MarcelKleiner/BallBalncer/00_General/AngleCalculation.docx

# Angle Calculation

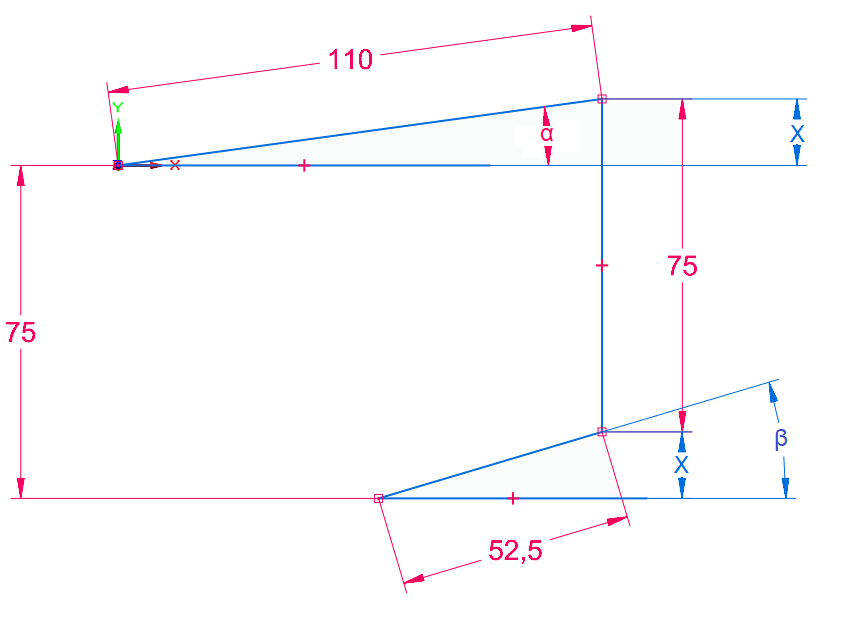
[picture p1: figure]

Target angle: α

x=sin(β)∙52.5=sin(α)∙110

β= sin^(-1) (110/52.5 ∙sin⁡(α) )

i∙EncoderValue= sin^(-1) (110/52.5∙sin⁡(α) ) where i = transmission ratio
