MarcelKleiner/BallBalncer/00_General/GateResistorCalculation.docx

# Gate resistor calculation

Calculation based on: https://www.ti.com/lit/ab/slla385a/slla385a.pdf?ts=1703426401381

(retrieved on 24.12.2023)

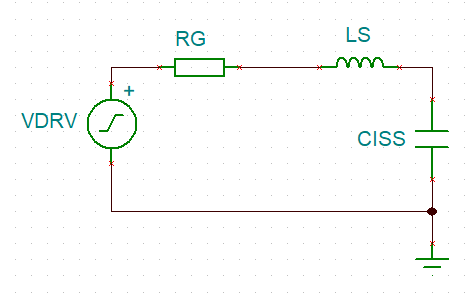
[picture p2: figure]

Calculating the source inductance Ls

L_S =1/(C_(ISS) *(2πf_R )^2)

The CISS of the DMN10H220LK3 is 384pF and a ring frequency of 4MHz

L_S =1/(384*(2π∙4000000)^2)= 4.122x10^(-6)

We need a quality factor Q between 0.5 and 1. A Value greater than 0.5 has a better dV/dt.
Q is defined as follow:

Q=(X_L)/(R_G)= (ωL_s)/(R_G)=>R_G =2πfL_s Q

With a Q of 0.7 we get a R_G of:

(2π∙4000000∙4.122x10^(-6))/0.5=207Ohm

To obtain the gate resistor, we need to subtract the gate resistor of the MOSFET (RG,I) and the resistor RHI or RLO of the gate driver. (RG = RHI or LO+RGATE+RG,I)

RGATE = 2.4Ohm (DMN10H220LK3)

Unfortunately, there is no reference to the RHI or RLO of the gate driver in the data sheet. We therefore assume that this is 0 ohms.

This results in a gate resistance of around 205 ohms.

Note: I have assumed that the ring frequency is 4 MHz. This value must be measured in order to obtain a correct result.
