MarcelKleiner/BallBalncer/01_Mechanical/gikr6-pw.stp

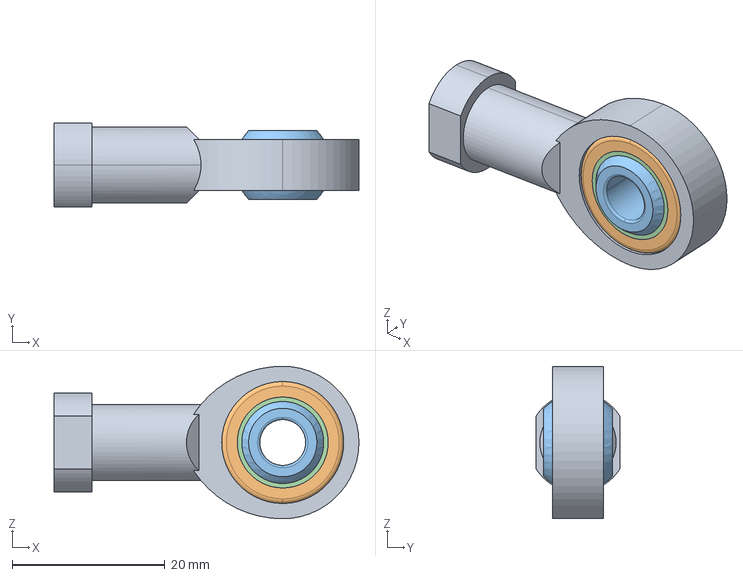
[picture p3: CAD file, 2024-01-01]
01_Mechanical/gikr6-pw.stp
40.0 x 11.0 x 20.0 mm
