MarcelKleiner/BallBalncer/01_Mechanical/Moto.step

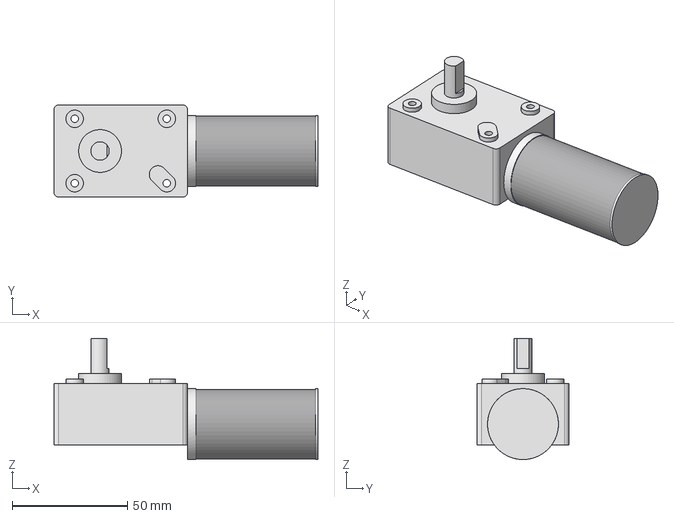
[picture p4: CAD file, 2024-01-01]
01_Mechanical/Moto.step
114.7 x 40.0 x 52.6 mm
