MarcelKleiner/BallBalncer/02_Hardware/BallBalancer/BallBalancer.kicad_pcb

## KiCad design 02_Hardware/BallBalancer/BallBalancer.kicad_pcb (2024-02-29)

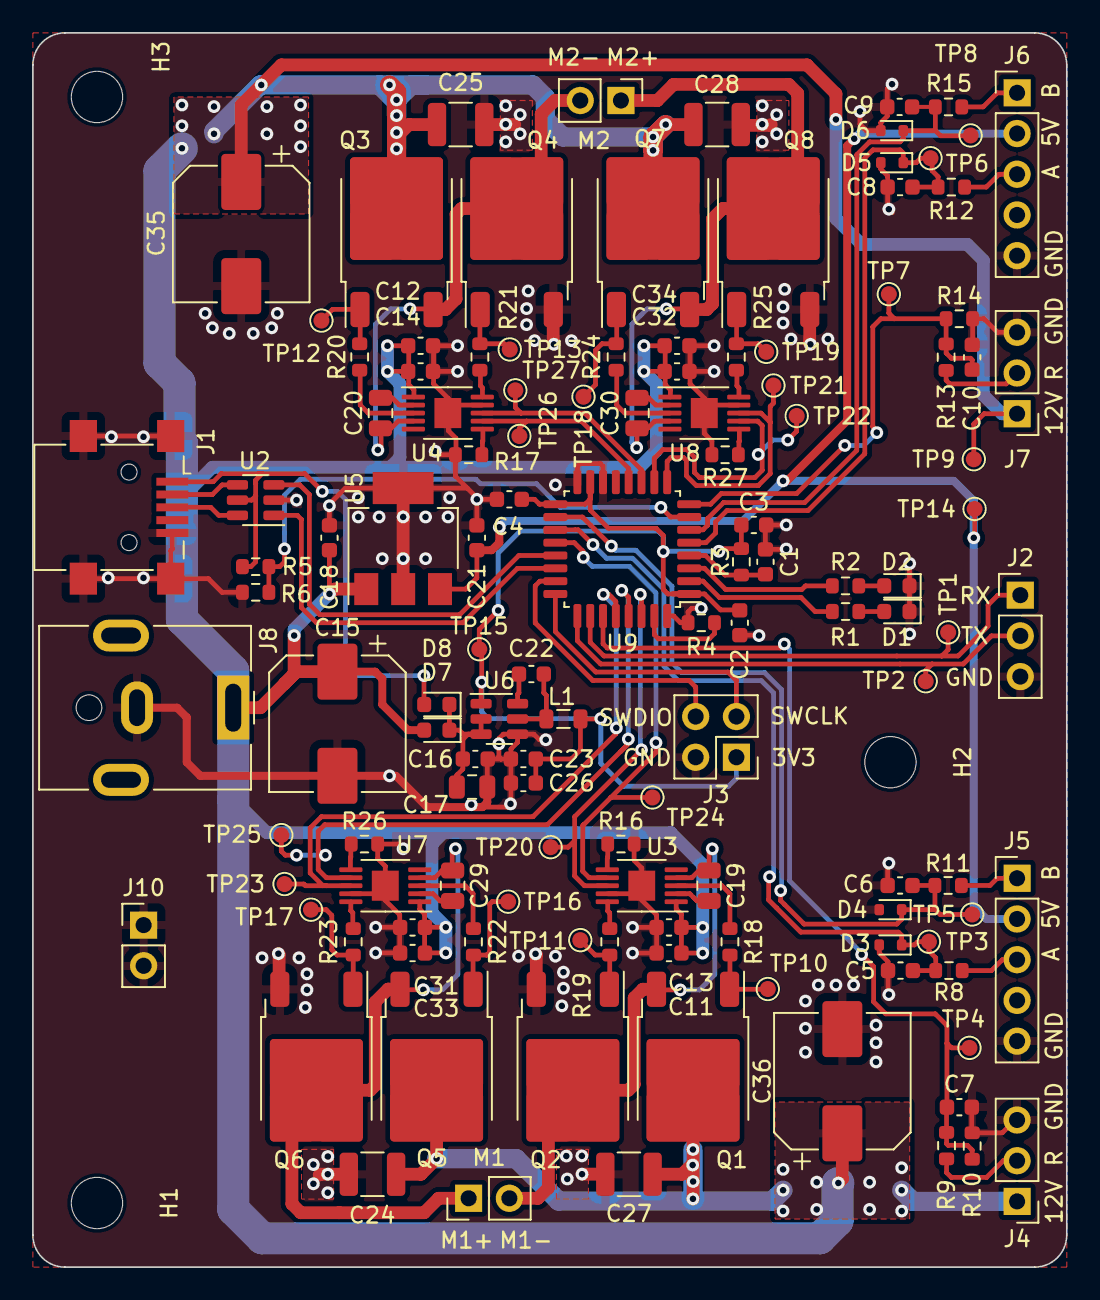
[picture p5: board BallBalancer.kicad_pcb from above]

Board: 2 copper layers, 64.5 x 77.0 mm, 128 parts (0 on the bottom side), 71 nets.

Parts:
C1, C2, C3, C4, C7, C10, C13, C14, C16, C18, C21, C22, C31, C32: 100n; C_0603_1608Metric
C5, C6, C8, C9: 1n; C_0603_1608Metric
C11, C12, C33, C34: 1u; C_0603_1608Metric
C15, C35, C36: 330u; CP_Elec_8x10
C17: 10u; C_0805_2012Metric
C19, C20, C29, C30: 1000p; C_0805_2012Metric
C23, C26: 22u; C_0603_1608Metric
C24, C25, C27, C28: 10u; C_1210_3225Metric
D1: LED_R; LED_0603_1608Metric
D2: LED_G; LED_0603_1608Metric
D3, D4, D5, D6: MM5Z3V3; D_SOD-523
D7, D8: SD0603; D_0603_1608Metric
H1, H2, H3: MountingHole; MountingHole_3.2mm_M3
J1: USB_B_Micro; USB_Mini-B_Lumberg_2486_01_Horizontal
J2: Raspberry PI UART; PinHeader_1x03_P2.54mm_Vertical
J3: SWD; PinHeader_2x02_P2.54mm_Vertical
J4: Reference switch 1; PinHeader_1x03_P2.54mm_Vertical
J5: ENCODER 1; PinHeader_1x05_P2.54mm_Vertical
J6: ENCODER 2; PinHeader_1x05_P2.54mm_Vertical
J7: Reference switch 2; PinHeader_1x03_P2.54mm_Vertical
J8: Jack-DC; BarrelJack_CUI_PJ-063AH_Horizontal
J10: GND; PinHeader_1x02_P2.54mm_Vertical
L1: 3.3u; L_0805_2012Metric
M1, M2: Motor_DC; PinHeader_1x02_P2.54mm_Vertical
Q1, Q2, Q3, Q4, Q5, Q6, Q7, Q8: DMN10H220L; TO-252-2
R1, R2: 240; R_0603_1608Metric
R3, R4: 100k; R_0603_1608Metric
R5, R8, R11, R12, R15, R16, R17, R26, R27: 10k; R_0603_1608Metric
R6: 15k; R_0603_1608Metric
R9, R13: 3.3k; R_0603_1608Metric
R10, R14: 1k; R_0603_1608Metric
R18, R19, R20, R21, R22, R23, R24, R25: 22; R_0603_1608Metric
TP1: UART_RX; TestPoint_Pad_D1.0mm
TP2: UART_TX; TestPoint_Pad_D1.0mm
TP3: ENCODER1_A; TestPoint_Pad_D1.0mm
TP4: REF_MOT1; TestPoint_Pad_D1.0mm
TP5: ENCODER1_B; TestPoint_Pad_D1.0mm
TP6: ENCODER2_A; TestPoint_Pad_D1.0mm
TP7: REF_MOT2; TestPoint_Pad_D1.0mm
TP8: ENCODER2_B; TestPoint_Pad_D1.0mm
TP9: 12V; TestPoint_Pad_D1.0mm
TP10: GH_CH1L; TestPoint_Pad_D1.0mm
TP11: GL_CH1L; TestPoint_Pad_D1.0mm
TP12: GH_CH2L; TestPoint_Pad_D1.0mm
TP13: GL_CH2L; TestPoint_Pad_D1.0mm
TP14: 5V; TestPoint_Pad_D1.0mm
TP15: 3.3V; TestPoint_Pad_D1.0mm
TP16: GH_CH1R; TestPoint_Pad_D1.0mm
TP17: GL_CH1R; TestPoint_Pad_D1.0mm
TP18: GH_CH2R; TestPoint_Pad_D1.0mm
TP19: GL_CH2R; TestPoint_Pad_D1.0mm
TP20, TP21, TP22, TP23, TP24, TP25, TP26, TP27: IN_CH2R; TestPoint_Pad_D1.0mm
U2: USBLC6-2SC6; SOT-23-6
U3, U4, U7, U8: DGD0506A; MSOP-10-1EP_3x3mm_P0.5mm_EP1.68x1.88mm
U5: LM2937IMP5; SOT-223-3_TabPin2
U6: AP63203WU; TSOT-23-6
U9: STM32G431K8Tx; LQFP-32_7x7mm_P0.8mm

Connections:
+3V3: C2.2, C3.2, C4.2, C23.2, C26.2, J3.1, L1.2, R3.1, TP15.1, U6.1 (FB), U9.1 (VDD), U9.15 (VDDA), U9.17 (VDD)
+5V: C21.1, J5.2, J6.2, TP14.1, U5.3 (VO)
+12V: C11.2, C12.2, C13.2, C14.2, C15.1, C18.1, C24.2, C25.2, C27.2, C28.2, C31.2, C32.2, C33.2, C34.2, C35.1, C36.1, D7.2 (A), J4.1, J7.1, J8.1, Q1.2 (D), Q3.2 (D), Q5.2 (D), Q7.2 (D), TP9.1, U3.1 (Vcc), U4.1 (Vcc), U5.1 (VI), U7.1 (Vcc), U8.1 (Vcc)
+12VA: C16.1, C17.1, D7.1 (K), D8.1 (K), U6.2 (EN), U6.3 (IN)
/Main/D+: J1.3 (D+), U2.6 (I/O1)
/Main/D-: J1.2 (D-), U2.4 (I/O2)
/Main/ENCODER1_A: C5.1, D3.1 (K), R8.2, TP3.1, U9.19 (PA9)
/Main/ENCODER1_A_OUT: J5.3, R8.1
/Main/ENCODER1_B: C6.1, D4.1 (K), R11.2, TP5.1, U9.18 (PA8)
/Main/ENCODER1_B_OUT: J5.1, R11.1
/Main/ENCODER2_A: C8.1, D5.1 (K), R12.2, TP6.1, U9.5 (PA0)
/Main/ENCODER2_A_OUT: J6.3, R12.1
/Main/ENCODER2_B: C9.1, D6.1 (K), R15.2, TP8.1, U9.6 (PA1)
/Main/ENCODER2_B_OUT: J6.1, R15.1
/Main/LED1: R1.1, U9.2 (PF0)
/Main/LED2: R2.1, U9.3 (PF1)
/Main/REF_MOT1: C7.1, R9.2, R10.1, TP4.1, U9.27 (PB4)
/Main/REF_MOT2: C10.1, R13.2, R14.1, TP7.1, U9.8 (PA3)
/Main/RSPI_RX: J2.2, TP2.1, U9.25 (PA15)
/Main/RSPI_TX: J2.1, TP1.1, U9.26 (PB3)
/Main/SWCLK: J3.3, U9.24 (PA14)
/Main/SWDIO: J3.4, U9.23 (PA13)
/Main/USB_DM: U2.3 (I/O2), U9.21 (PA11)
/Main/USB_DP: U2.1 (I/O1), U9.22 (PA12)
/Main/VUSB: R5.2, R6.2, U9.7 (PA2)
EN_MOT_CH1L: TP24.1, U3.7 (EN), U9.20 (PA10)
EN_MOT_CH1R: TP25.1, U7.7 (EN), U9.29 (PB6)
EN_MOT_CH2L: TP26.1, U4.7 (EN), U9.12 (PA7)
EN_MOT_CH2R: TP22.1, U8.7 (EN), U9.10 (PA5)
GND: C1.1, C2.1, C3.1, C4.1, C5.2, C6.2, C7.2, C8.2, C9.2, C10.2, C11.1, C12.1, C13.1, C14.1, C15.2, C16.2, C17.2, C18.2, C21.2, C23.1, C24.1, C25.1, C26.1, C27.1, C28.1, C31.1, C32.1, C33.1, C34.1, C35.2, C36.2, D1.1 (K), D2.1 (K), D3.2 (A), D4.2 (A), D5.2 (A), D6.2 (A), J1.5 (GND), J1.6 (Shield), J2.3, J3.2, J4.3, J5.5, J6.5, J7.3, J8.2, J10.1, J10.2, Q2.3 (S), Q4.3 (S), Q6.3 (S), Q8.3 (S), R4.1, R6.1, R10.2, R14.2, R16.2, R17.2, R26.2, R27.2, U2.2 (GND), U3.9 (COM), U3.11 (PAD), U4.9 (COM), U4.11 (PAD), U5.2 (GND), U6.4 (GND), U7.9 (COM), U7.11 (PAD), U8.9 (COM), U8.11 (PAD), U9.14 (VSSA), U9.16 (VSS), U9.32 (VSS)
IN_MOT_CH1L: TP20.1, U3.8 (IN), U9.30 (PB7)
IN_MOT_CH1R: TP23.1, U7.8 (IN), U9.28 (PB5)
IN_MOT_CH2L: TP27.1, U4.8 (IN), U9.11 (PA6)
IN_MOT_CH2R: TP21.1, U8.8 (IN), U9.9 (PA4)
unnamed: D1.2 (A), R1.2
unnamed: D2.2 (A), R2.2
unnamed: J4.2, R9.1
unnamed: J7.2, R13.1
unnamed: C29.1, M1.1 (+), Q5.3 (S), Q6.2 (D), U7.4 (Vs)
unnamed: C19.1, M1.2 (-), Q1.3 (S), Q2.2 (D), U3.4 (Vs)
unnamed: C30.1, M2.1 (+), Q7.3 (S), Q8.2 (D), U8.4 (Vs)
unnamed: C20.1, M2.2 (-), Q3.3 (S), Q4.2 (D), U4.4 (Vs)
unnamed: Q1.1 (G), R18.1, TP10.1
unnamed: Q2.1 (G), R19.2, TP11.1
unnamed: Q3.1 (G), R20.1, TP12.1
unnamed: Q4.1 (G), R21.2, TP13.1
unnamed: Q5.1 (G), R22.1, TP16.1
unnamed: Q6.1 (G), R23.2, TP17.1
unnamed: Q7.1 (G), R24.1, TP18.1
unnamed: Q8.1 (G), R25.2, TP19.1
unnamed: R16.1, U3.6 (DT)
unnamed: R18.2, U3.3 (HO)
unnamed: R19.1, U3.10 (LO)
unnamed: C19.2, U3.2 (VB)
unnamed: R17.1, U4.6 (DT)
unnamed: R20.2, U4.3 (HO)
unnamed: R21.1, U4.10 (LO)
unnamed: C20.2, U4.2 (VB)
unnamed: C22.2, U6.6 (BST)
unnamed: C22.1, L1.1, U6.5 (SW)
unnamed: R26.1, U7.6 (DT)
unnamed: R22.2, U7.3 (HO)
unnamed: R23.1, U7.10 (LO)
unnamed: C29.2, U7.2 (VB)
unnamed: R27.1, U8.6 (DT)
unnamed: R24.2, U8.3 (HO)
unnamed: R25.1, U8.10 (LO)
unnamed: C30.2, U8.2 (VB)
unnamed: R4.2, U9.31 (PB8)
unnamed: C1.2, R3.2, U9.4 (PG10)
VBUS: D8.2 (A), J1.1 (VBUS), R5.1, U2.5 (VBUS)
