MarcelKleiner/BallBalncer/03_Firmware/G431/Core/Src/main.cpp

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
/* Includes ------------------------------------------------------------------*/
#include "main.h"
#include "adc.h"
#include "tim.h"
#include "usart.h"
#include "usb_device.h"
#include "gpio.h"

/* USER CODE BEGIN Includes */
#include "AppMain/ApplicationMain.h"
/* USER CODE END Includes */

/* USER CODE BEGIN PTD */
  ApplicationMain applicationMain = ApplicationMain();
/* USER CODE END PTD */


void SystemClock_Config(void);
/**
  * @brief  The application entry point.
  * @retval int
  */
int main(void)
{
  /* MCU Configuration--------------------------------------------------------*/

  /* Reset of all peripherals, Initializes the Flash interface and the Systick. */
  HAL_Init();

  /* Configure the system clock */
  SystemClock_Config();

  /* Initialize all configured peripherals */
  MX_GPIO_Init();
  MX_ADC1_Init();
  MX_TIM1_Init();
  MX_TIM2_Init();
  MX_TIM3_Init();
  MX_TIM4_Init();
  MX_TIM17_Init();
  MX_USART2_UART_Init();
  MX_USB_Device_Init();
  /* USER CODE BEGIN 2 */
  applicationMain.StartUp();
  /* USER CODE END 2 */

  /* Infinite loop */
  /* USER CODE BEGIN WHILE */
  while (1)
  {
    /* USER CODE END WHILE */

    /* USER CODE BEGIN 3 */
  }
  /* USER CODE END 3 */
}

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
/* USER CODE BEGIN 4 */
void HAL_TIM_PeriodElapsedCallback(TIM_HandleTypeDef *htim){

	if(htim->Instance == TIM4){
		applicationMain.taskhandler.UpdateTaskhandler();
	}

}
/* USER CODE END 4 */
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
