MarcelKleiner/BallBalncer/03_Firmware/G431/Core/Inc/main.h

#define LEDG_Pin GPIO_PIN_0
#define LEDG_GPIO_Port GPIOF
#define LEDR_Pin GPIO_PIN_1
#define LEDR_GPIO_Port GPIOF
#define ENCODER2_A_Pin GPIO_PIN_0
#define ENCODER2_A_GPIO_Port GPIOA
#define ENCODER2_B_Pin GPIO_PIN_1
#define ENCODER2_B_GPIO_Port GPIOA
#define VUSB_Pin GPIO_PIN_2
#define VUSB_GPIO_Port GPIOA
#define REF_MOT2_Pin GPIO_PIN_3
#define REF_MOT2_GPIO_Port GPIOA
#define IN_MOT_CH2R_Pin GPIO_PIN_4
#define IN_MOT_CH2R_GPIO_Port GPIOA
#define EN_MOT_CH2R_Pin GPIO_PIN_5
#define EN_MOT_CH2R_GPIO_Port GPIOA
#define IN_MOT_CH2L_Pin GPIO_PIN_6
#define IN_MOT_CH2L_GPIO_Port GPIOA
#define EN_MOT_CH2L_Pin GPIO_PIN_7
#define EN_MOT_CH2L_GPIO_Port GPIOA
#define ENCODER1_B_Pin GPIO_PIN_8
#define ENCODER1_B_GPIO_Port GPIOA
#define ENCODER1_A_Pin GPIO_PIN_9
#define ENCODER1_A_GPIO_Port GPIOA
#define EN_MOT_CH1L_Pin GPIO_PIN_10
#define EN_MOT_CH1L_GPIO_Port GPIOA
#define REF_MOT1_Pin GPIO_PIN_4
#define REF_MOT1_GPIO_Port GPIOB
#define IN_MOT_CH1R_Pin GPIO_PIN_5
#define IN_MOT_CH1R_GPIO_Port GPIOB
#define EN_MOT_CH1R_Pin GPIO_PIN_6
#define EN_MOT_CH1R_GPIO_Port GPIOB
#define IN_MOT_CH1L_Pin GPIO_PIN_7
#define IN_MOT_CH1L_GPIO_Port GPIOB
