MarcelKleiner/BallBalncer/03_Firmware/G431/Core/Src/IO/IOFunction.h

/*
 * IOFunction.h
 *
 *  Created on: Jan 1, 2024
 *      Author: marce
 */

#ifndef SRC_IO_IOFUNCTION_H_
#define SRC_IO_IOFUNCTION_H_

enum IOFunction
{
	NotDefined = 0,
	Input,
	Output,
	PWM
};



#endif /* SRC_IO_IOFUNCTION_H_ */
