MarcelKleiner/BallBalncer/(commit log)

2023-12-23 add hardware
    [BallBalancer.kicad_pcb, BallBalancer.kicad_sch, Main.kicad_sch, MotorControl.kicad_sch, MotorControl_Supply.kicad_sch, Supply.kicad_sch]
2023-12-23 Hardware schema and layout created
    [BallBalancer.kicad_pcb, MotorControl_Supply.kicad_sch]
2023-12-23 ERC and DRC warnings and errors in schema and layout fixed
    [BallBalancer.kicad_pcb, Main.kicad_sch, MotorControl_Supply.kicad_sch]
2023-12-25 Test points added and BOM created
    [BallBalancer-B_Cu.gbr, BallBalancer-B_Mask.gbr, BallBalancer-B_Paste.gbr, BallBalancer-Edge_Cuts.gbr, BallBalancer-F_Cu.gbr, BallBalancer-F_Mask.gbr, BallBalancer-F_Paste.gbr, BallBalancer-F_Silkscreen.gbr]
2024-01-01 CAD files and hardware manufacturing data added
    [AMT102-V.cfg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]
2024-02-11 update firmware, hardware and software
    [BOM.csv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]
2024-02-11 motor1 left turn implemented
    [Timer.xlsx]
2024-02-17 replace microcontroller
    [BallBalancer.kicad_pcb, Main.kicad_sch]
2024-02-17 Layout completed with stm32g431
    [BallBalancer-B_Cu.gbr, BallBalancer-B_Mask.gbr, BallBalancer-B_Paste.gbr, BallBalancer-Edge_Cuts.gbr, BallBalancer-F_Cu.gbr, BallBalancer-F_Mask.gbr, BallBalancer-F_Paste.gbr, BallBalancer-F_Silkscreen.gbr]
2024-02-29 update layout
    [BallBalancer-B_Cu.gbr, BallBalancer-B_Mask.gbr, BallBalancer-B_Paste.gbr, BallBalancer-Edge_Cuts.gbr, BallBalancer-F_Cu.gbr, BallBalancer-F_Mask.gbr, BallBalancer-F_Paste.gbr, BallBalancer-F_Silkscreen.gbr]
