MarcelKleiner/BallBalncer/(notices)

Notices in the files:
03_Firmware/G431/Core/Src/main.cpp:
Copyright (c) 2024 STMicroelectronics.
All rights reserved.
This software is licensed under terms that can be found in the LICENSE file
